WAC-KP/kaypro-81-194-cpld-replacement/hardware/Version 2/u29-1504 Front.png

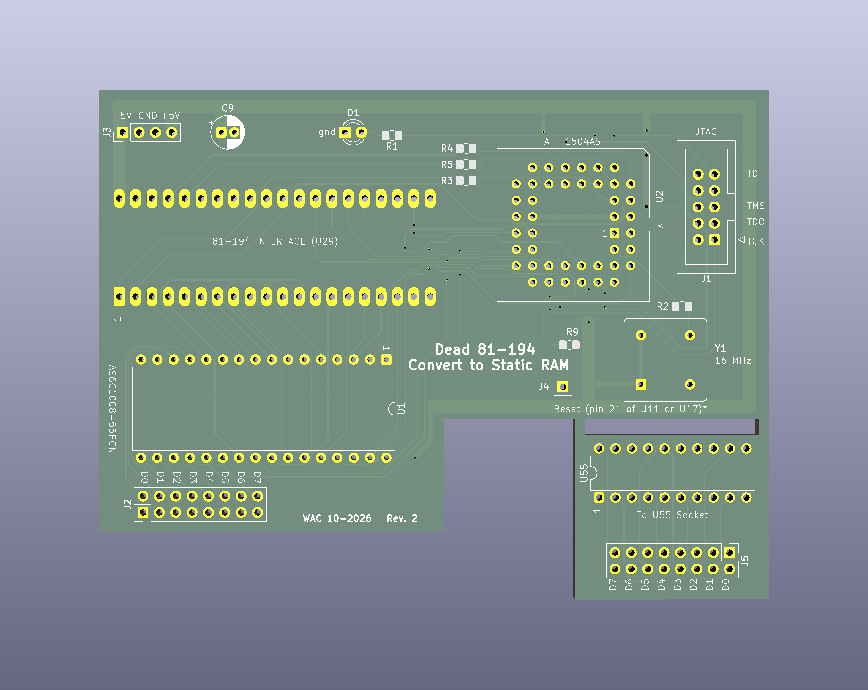
hardware/Version 2/u29-1504 Front.png
