WAC-KP/kaypro-81-194-cpld-replacement/hardware/Version 2/production/bom.csv

Designator | Footprint | Quantity | Value | LCSC Part #
C1, C2, C3, C4, C5, C6, C7 | 0805 | 7 | C100n
C8 | 0805 | 1 | C1mFd
C9 | CP_Radial_D5.0mm_P2.00mm | 1 | C_Polarized_47_mFd
D1 | LED_D3.0mm | 1 | LED
J1 | IDC-Header_2x05_P2.54mm_Vertical | 1 | Conn_02x05_Odd_Even
J2, J5 | PinHeader_2x08_P2.54mm_Vertical | 2 | Conn_02x08_Odd_Even
J3 | PinHeader_1x04_P2.54mm_Vertical | 1 | Conn_01x04_Pin
J4 | PinHeader_1x01_P2.54mm_Vertical | 1 | Conn_01x01_Pin
R1 | 0805 | 1 | 470
R2 | 0805 | 1 | R33
R3, R4, R5 | 0805 | 3 | 33
R6, R7, R8, R9 | 0805 | 4 | 10k
U1 | DIP-32_W15.24mm | 1 | AS6C1008-xxP
U2 | PLCC-44_THT-Socket | 1 | ATF1504AS-10JU44
U29 | WAC-2X40_W15.24mm_LongPads | 1 | Replacemnt
U55 | DIP-20_W7.62mm | 1 | 74LS373
Y1 | Oscillator_DIP-8 | 1 | CXO_DIP8
