WAC-KP/kaypro-81-194-cpld-replacement/hardware/Version 1/u29-1504.pdf

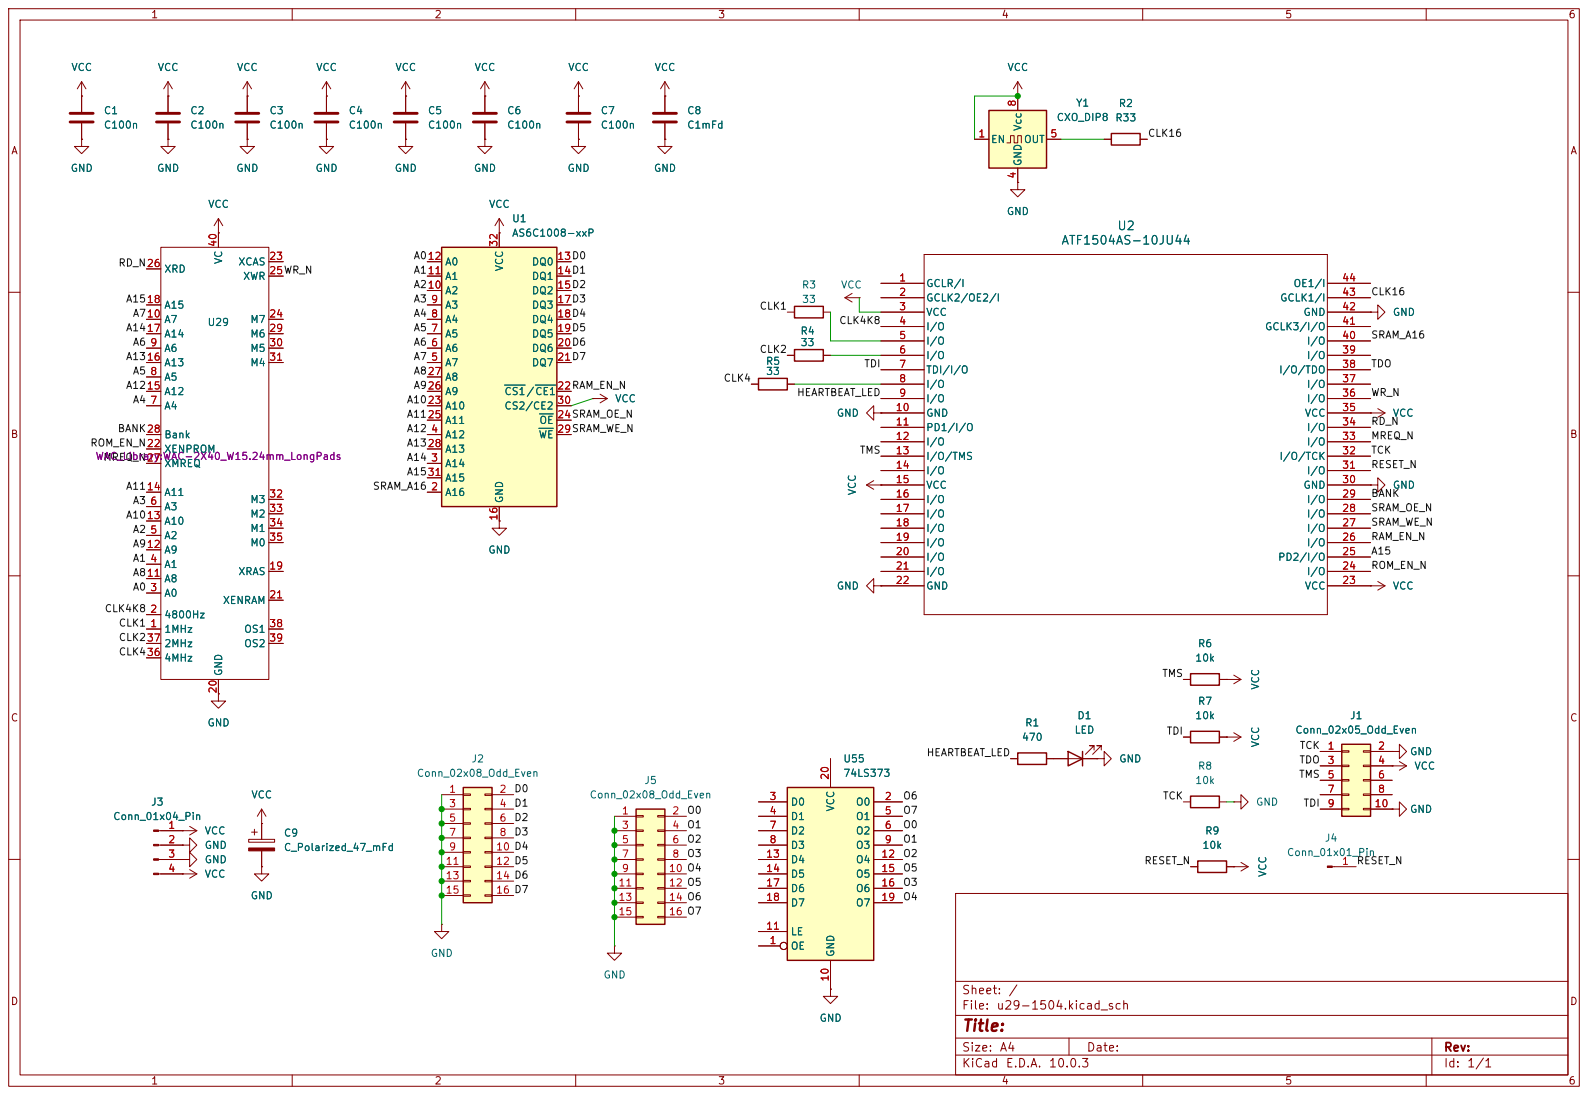
[picture p4: page 1]

Size: A4 | Rev:
KiCad E.D.A. 10.0.3 | Id: 1/1
