WAC-KP/kaypro-81-194-cpld-replacement/hardware/Version 1/u29-1504.kicad_pcb

## KiCad design hardware/Version 1/u29-1504.kicad_pcb (2026-10-28, an earlier design)

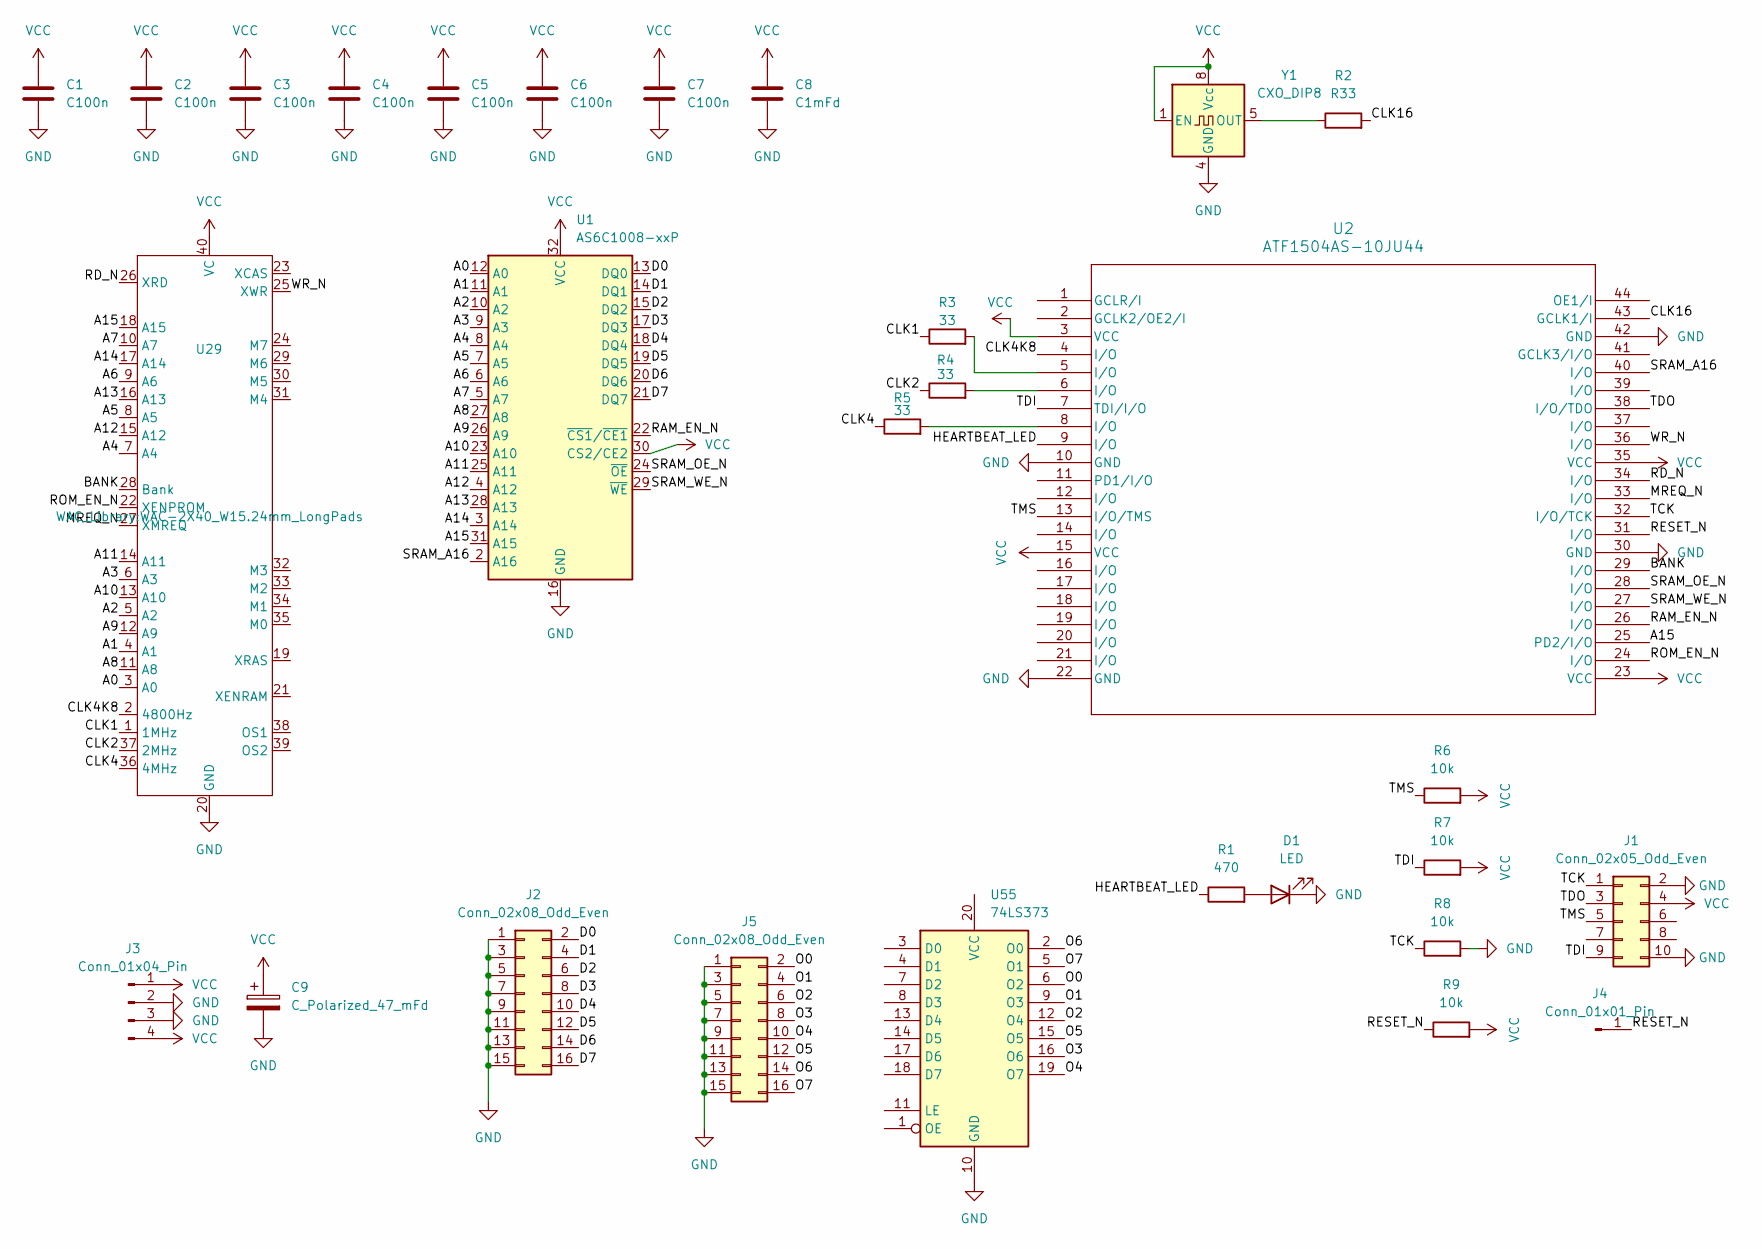
[picture p5: schematic u29-1504.kicad_sch]

Parts:
C1, C2, C3, C4, C5, C6, C7: C100n; C_0805_2012Metric_Pad1.18x1.45mm_HandSolder
C8: C1mFd; C_0805_2012Metric_Pad1.18x1.45mm_HandSolder
C9: C_Polarized_47_mFd; CP_Radial_D5.0mm_P2.00mm
D1: LED; LED_D3.0mm
J1: Conn_02x05_Odd_Even; IDC-Header_2x05_P2.54mm_Vertical
J2, J5: Conn_02x08_Odd_Even; PinHeader_2x08_P2.54mm_Vertical
J3: Conn_01x04_Pin; PinHeader_1x04_P2.54mm_Vertical
J4: Conn_01x01_Pin; PinHeader_1x01_P2.54mm_Vertical
R1: 470; R_0805_2012Metric_Pad1.20x1.40mm_HandSolder
R2: R33; R_0805_2012Metric_Pad1.20x1.40mm_HandSolder
R3, R4, R5: 33; R_0805_2012Metric_Pad1.20x1.40mm_HandSolder
R6, R7, R8, R9: 10k; R_0805_2012Metric_Pad1.20x1.40mm_HandSolder
U1: AS6C1008-xxP; DIP-32_W15.24mm
U2: ATF1504AS-10JU44; PLCC-44_THT-Socket
U29: Replacemnt; WAC-2X40_W15.24mm_LongPads
U55: 74LS373; DIP-20_W7.62mm
Y1: CXO_DIP8; Oscillator_DIP-8

Connections:
/A0: U1.12 (A0), U29.3 (A0)
/A1: U1.11 (A1), U29.4 (A1)
/A2: U1.10 (A2), U29.5 (A2)
/A3: U1.9 (A3), U29.6 (A3)
/A4: U1.8 (A4), U29.7 (A4)
/A5: U1.7 (A5), U29.8 (A5)
/A6: U1.6 (A6), U29.9 (A6)
/A7: U1.5 (A7), U29.10 (A7)
/A8: U1.27 (A8), U29.11 (A8)
/A9: U1.26 (A9), U29.12 (A9)
/A10: U1.23 (A10), U29.13 (A10)
/A11: U1.25 (A11), U29.14 (A11)
/A12: U1.4 (A12), U29.15 (A12)
/A13: U1.28 (A13), U29.16 (A13)
/A14: U1.3 (A14), U29.17 (A14)
/A15: U1.31 (A15), U2.25 (PD2/I/O), U29.18 (A15)
/BANK: U2.29 (I/O), U29.28 (Bank)
/CLK1: R3.1, U29.1 (1MHz)
/CLK2: R4.1, U29.37 (2MHz)
/CLK4: R5.1, U29.36 (4MHz)
/CLK4K8: U2.4 (I/O), U29.2 (4800Hz)
/CLK16: R2.2, U2.43 (GCLK1/I)
/D0: J2.2, U1.13 (DQ0)
/D1: J2.4, U1.14 (DQ1)
/D2: J2.6, U1.15 (DQ2)
/D3: J2.8, U1.17 (DQ3)
/D4: J2.10, U1.18 (DQ4)
/D5: J2.12, U1.19 (DQ5)
/D6: J2.14, U1.20 (DQ6)
/D7: J2.16, U1.21 (DQ7)
/HEARTBEAT_LED: R1.1, U2.9 (I/O)
/MREQ_N: U2.33 (I/O), U29.27 (XMREQ)
/O0: J5.2, U55.6 (O2)
/O1: J5.4, U55.9 (O3)
/O2: J5.6, U55.12 (O4)
/O3: J5.8, U55.16 (O6)
/O4: J5.10, U55.19 (O7)
/O5: J5.12, U55.15 (O5)
/O6: J5.14, U55.2 (O0)
/O7: J5.16, U55.5 (O1)
/RAM_EN_N: U1.22 (~CS1/~CE1), U2.26 (I/O)
/RD_N: U2.34 (I/O), U29.26 (XRD)
/RESET_N: J4.1 (Pin_1_1), R9.1, U2.31 (I/O)
/ROM_EN_N: U2.24 (I/O), U29.22 (XENPROM)
/SRAM_A16: U1.2 (A16), U2.40 (I/O)
/SRAM_OE_N: U1.24 (~OE), U2.28 (I/O)
/SRAM_WE_N: U1.29 (~WE), U2.27 (I/O)
/TCK: J1.1, R8.1, U2.32 (I/O/TCK)
/TDI: J1.9, R7.1, U2.7 (TDI/I/O)
/TDO: J1.3, U2.38 (I/O/TDO)
/TMS: J1.5, R6.1, U2.13 (I/O/TMS)
/WR_N: U2.36 (I/O), U29.25 (XWR)
GND: C1.2, C2.2, C3.2, C4.2, C5.2, C6.2, C7.2, C8.2, C9.2, D1.1 (K), J1.2, J1.10, J2.1, J2.3, J2.5, J2.7, J2.9, J2.11, J2.13, J2.15, J3.2, J3.3, J5.1, J5.3, J5.5, J5.7, J5.9, J5.11, J5.13, J5.15, R8.2, U1.16 (GND), U2.10 (GND), U2.22 (GND), U2.30 (GND), U2.42 (GND), U29.20 (GND), U55.10 (GND), Y1.4 (GND)
unnamed: D1.2 (A), R1.2
unnamed: R3.2, U2.5 (I/O)
unnamed: R4.2, U2.6 (I/O)
unnamed: R5.2, U2.8 (I/O)
unnamed: R2.1, Y1.5 (OUT)
VCC: C1.1, C2.1, C3.1, C4.1, C5.1, C6.1, C7.1, C8.1, C9.1, J1.4, J3.1, J3.4, R6.2, R7.2, R9.2, U1.30 (CS2/CE2), U1.32 (VCC), U2.3 (VCC), U2.15 (VCC), U2.23 (VCC), U2.35 (VCC), U29.40 (VC), Y1.1 (EN), Y1.8 (Vcc)

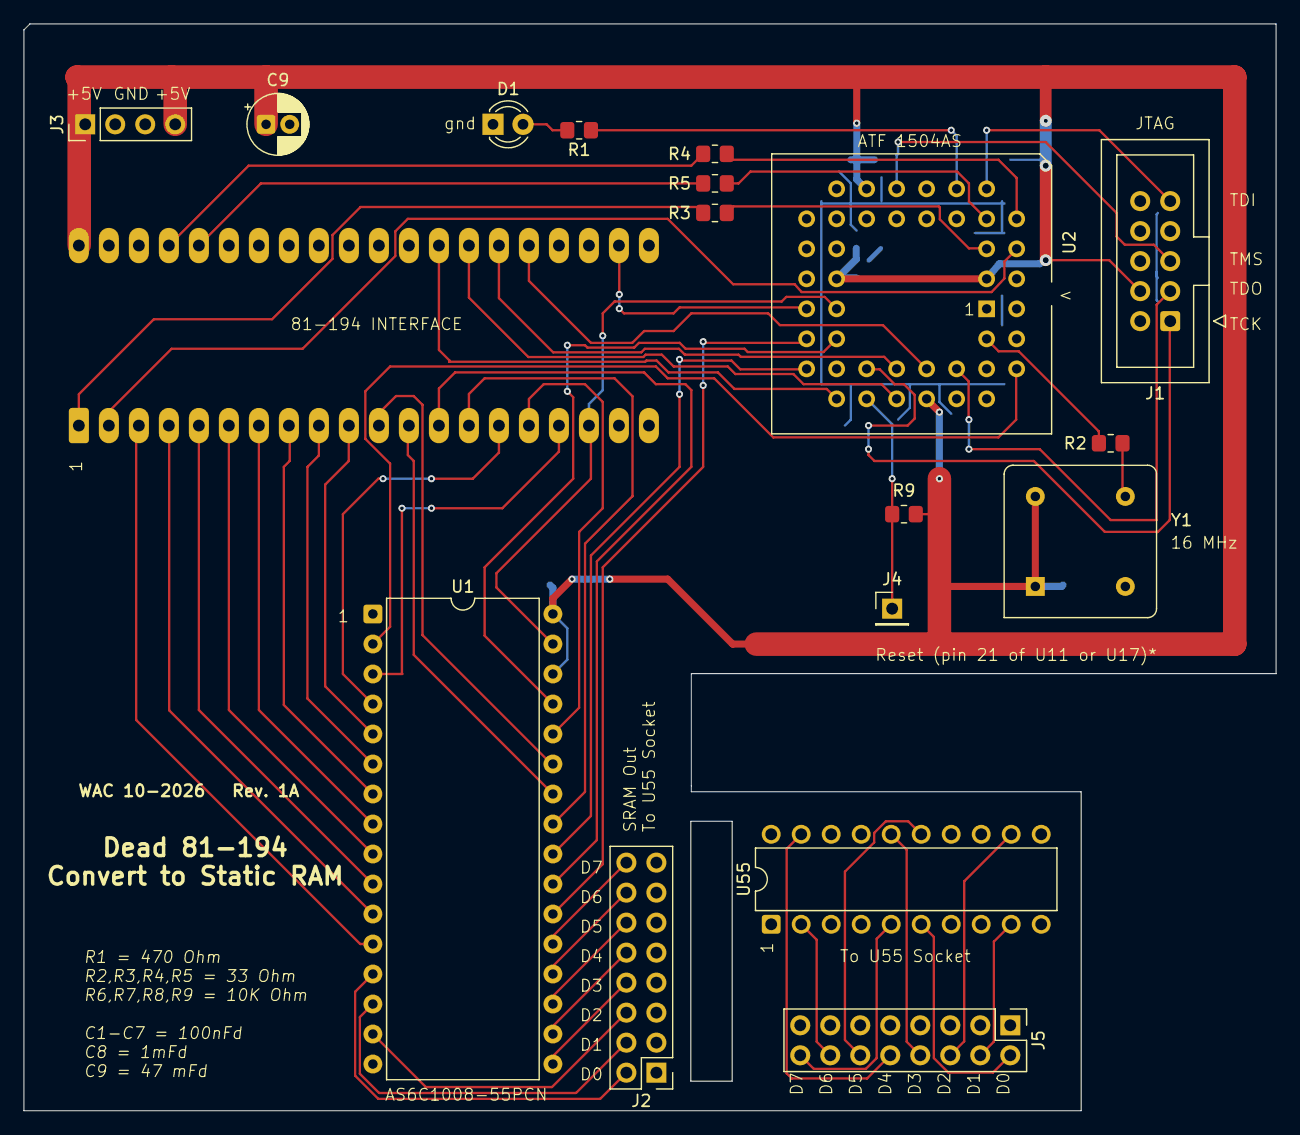
[picture p6: board u29-1504.kicad_pcb from above]

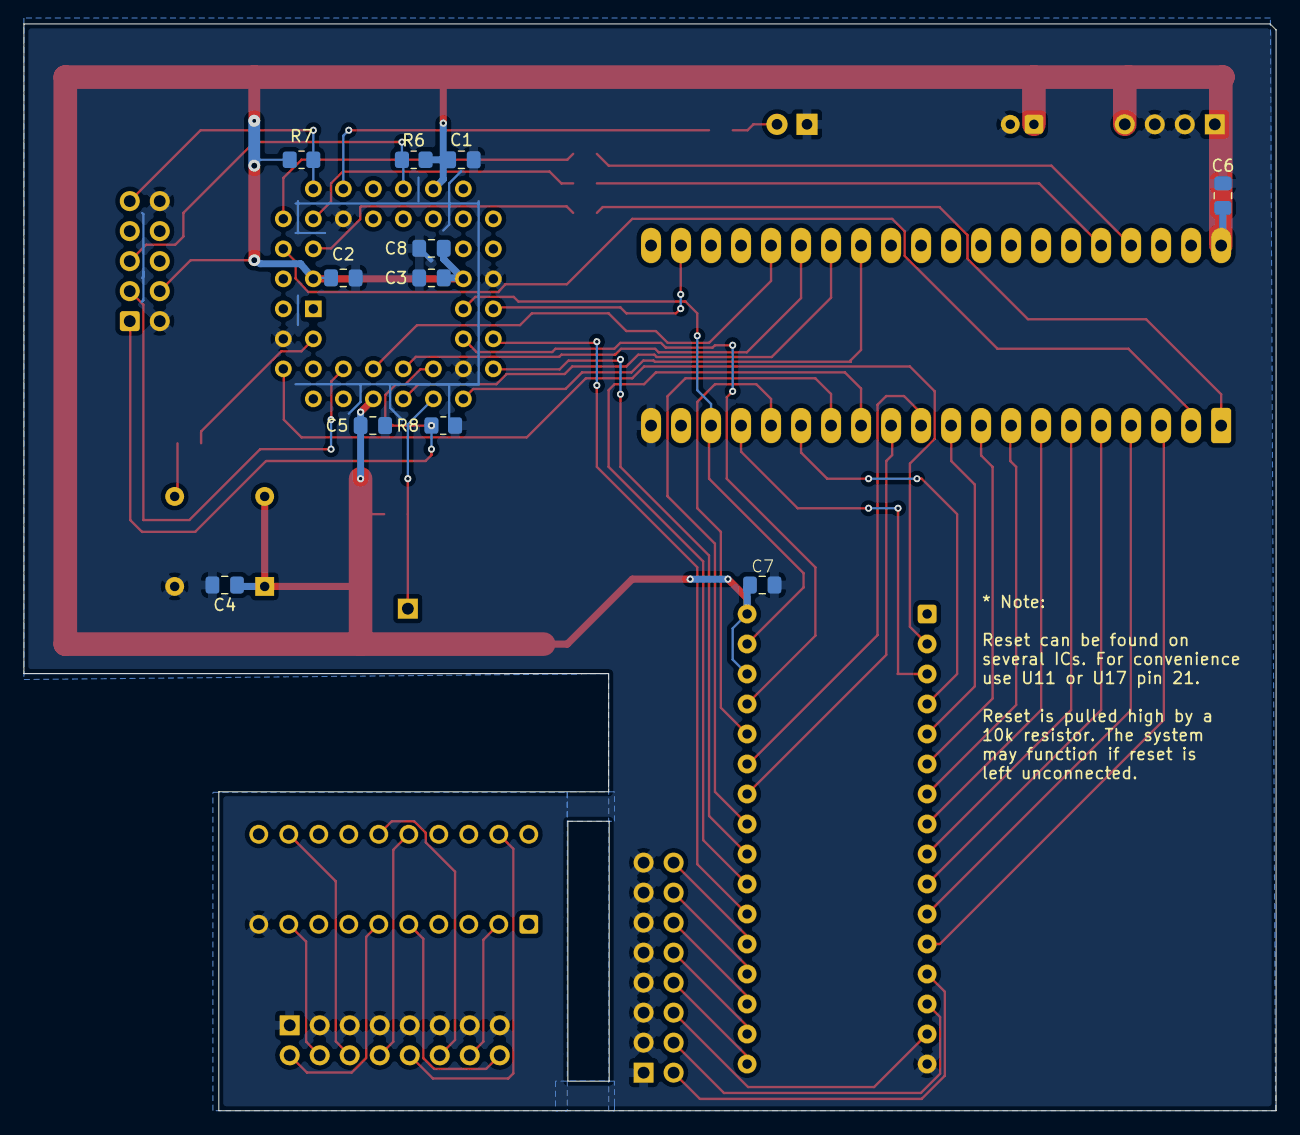
[picture p7: board u29-1504.kicad_pcb from below]

Board: 2 copper layers, 106.0 x 92.0 mm, 29 parts (11 on the bottom side), 59 nets.
