WAC-KP/kaypro-81-194-cpld-replacement/(commit log)

2026-10-28 Update README with project files and download links
    Added download links for hardware, PCB fabrication, and firmware files.
2026-10-28 Clarify Gerber files and add compiling/programming instructions
    Updated the README to clarify Gerber file versions and added sections for compiling and programming.
2026-10-28 Fix links and update descriptions in README.md
    Updated links in the README for hardware and resources sections, including versioning for Gerber files and added WCHISPStudio link.
2026-10-28 Revise hardware damage disclaimer for Kaypro equipment
    Updated the hardware damage disclaimer to specify risks associated with the Kaypro Universal Board and added detailed warnings regarding installation and usage.
2026-10-28 Add building and installing instructions to README
    Added a section on building and installing the PCB, including detailed instructions and specifications.
